FiberAndFiber/stm32f030f4p6_MAX7219_LED/software/Demo/User/inc/SOFT_SPI_DRIVER.h

#ifndef __SOFE_SPI_DRIVER_H
#define __SOFE_SPI_DRIVER_H

void SOFE_SPI_DRIVER_INIT(void);
void SOFE_SPI_DRIVER_START(void);
void SOFE_SPI_DRIVER_END(void);
void SOFE_SPI_DRIVER_SendByte(uint8_t ByteSend);

#endif
