FiberAndFiber/stm32f030f4p6_MAX7219_LED/software/Demo/Project/project.uvguix.V

<?xml version="1.0" encoding="UTF-8" standalone="no" ?>
<ProjectGui xmlns:xsi="http://www.w3.org/2001/XMLSchema-instance" xsi:noNamespaceSchemaLocation="project_guix.xsd">

  <SchemaVersion>-6.1</SchemaVersion>

  <Header>### uVision Project, (C) Keil Software</Header>

  <ViewPool/>

  <SECTreeCtrl>
    <View>
      <WinId>38003</WinId>
      <ViewName>Registers</ViewName>
      <TableColWidths>115 109</TableColWidths>
    </View>
    <View>
      <WinId>346</WinId>
      <ViewName>Code Coverage</ViewName>
      <TableColWidths>526 160</TableColWidths>
    </View>
    <View>
      <WinId>204</WinId>
      <ViewName>Performance Analyzer</ViewName>
      <TableColWidths>686</TableColWidths>
    </View>
  </SECTreeCtrl>

  <TreeListPane>
    <View>
      <WinId>1506</WinId>
      <ViewName>Symbols</ViewName>
      <UserString></UserString>
      <TableColWidths>47 47 47</TableColWidths>
    </View>
    <View>
      <WinId>1936</WinId>
      <ViewName>Watch 1</ViewName>
      <UserString></UserString>
      <TableColWidths>47 47 47</TableColWidths>
    </View>
    <View>
      <WinId>1937</WinId>
      <ViewName>Watch 2</ViewName>
      <UserString></UserString>
      <TableColWidths>47 47 47</TableColWidths>
    </View>
    <View>
      <WinId>1935</WinId>
      <ViewName>Call Stack + Locals</ViewName>
      <UserString></UserString>
      <TableColWidths>47 47 47</TableColWidths>
    </View>
    <View>
      <WinId>2506</WinId>
      <ViewName>Trace Data</ViewName>
      <UserString></UserString>
      <TableColWidths>75 135 130 95 70 230 200 150</TableColWidths>
    </View>
    <View>
      <WinId>466</WinId>
      <ViewName>Source Browser</ViewName>
      <UserString>300</UserString>
      <TableColWidths>0</TableColWidths>
    </View>
  </TreeListPane>

  <CompViewPool/>

  <WindowSettings>
    <LogicAnalizer>
      <ShowLACursor>1</ShowLACursor>
      <ShowSignalInfo>1</ShowSignalInfo>
      <ShowCycles>0</ShowCycles>
      <LeftSideBarSize>0</LeftSideBarSize>
      <TimeBaseIndex>-1</TimeBaseIndex>
    </LogicAnalizer>
  </WindowSettings>

  <WinLayoutEx>
    <sActiveDebugView></sActiveDebugView>
    <WindowPosition>
      <length>44</length>
      <flags>2</flags>
      <showCmd>3</showCmd>
      <MinPosition>
        <xPos>-1</xPos>
        <yPos>-1</yPos>
      </MinPosition>
      <MaxPosition>
        <xPos>-1</xPos>
        <yPos>-1</yPos>
      </MaxPosition>
      <NormalPosition>
        <Top>131</Top>
        <Left>182</Left>
        <Right>1279</Right>
        <Bottom>679</Bottom>
      </NormalPosition>
    </WindowPosition>
    <MDIClientArea>
      <RegID>0</RegID>
      <MDITabState>
        <Len>60</Len>
        <Data>010000000400000001000000010000000100000001000000000000000200000000000000010000000100000000000000280000002800000000000000</Data>
      </MDITabState>
    </MDIClientArea>
    <ViewEx>
      <ViewType>0</ViewType>
      <ViewName>Build</ViewName>
      <Window>
        <RegID>-1</RegID>
        <PaneID>-1</PaneID>
        <IsVisible>0</IsVisible>
        <IsFloating>0</IsFloating>
        <IsTabbed>0</IsTabbed>
        <IsActivated>0</IsActivated>
        <MRUWidth>32767</MRUWidth>
        <PinState>0</PinState>
        <RecentFrameAlignment>4096</RecentFrameAlignment>
        <RecentRowIndex>0</RecentRowIndex>
        <RectRecentDocked>
          <Len>16</Len>
          <Data>920000004F0000004603000084000000</Data>
        </RectRecentDocked>
        <RectRecentFloat>
          <Len>16</Len>
          <Data>9200000066000000460300009B000000</Data>
        </RectRecentFloat>
      </Window>
      <Window>
        <RegID>1005</RegID>
        <PaneID>1005</PaneID>
        <IsVisible>1</IsVisible>
        <IsFloating>0</IsFloating>
        <IsTabbed>0</IsTabbed>
        <IsActivated>0</IsActivated>
        <MRUWidth>32767</MRUWidth>
        <PinState>0</PinState>
        <RecentFrameAlignment>4096</RecentFrameAlignment>
        <RecentRowIndex>0</RecentRowIndex>
        <RectRecentDocked>
          <Len>16</Len>
          <Data>0300000066000000E7000000A5010000</Data>
        </RectRecentDocked>
        <RectRecentFloat>
          <Len>16</Len>
          <Data>7000000087000000FE000000F8000000</Data>
        </RectRecentFloat>
      </Window>
      <Window>
        <RegID>109</RegID>
        <PaneID>109</PaneID>
        <IsVisible>1</IsVisible>
        <IsFloating>0</IsFloating>
        <IsTabbed>0</IsTabbed>
        <IsActivated>0</IsActivated>
        <MRUWidth>32767</MRUWidth>
        <PinState>0</PinState>
        <RecentFrameAlignment>4096</RecentFrameAlignment>
        <RecentRowIndex>0</RecentRowIndex>
        <RectRecentDocked>
          <Len>16</Len>
          <Data>0300000066000000E7000000A5010000</Data>
        </RectRecentDocked>
        <RectRecentFloat>
          <Len>16</Len>
          <Data>700000008700000017010000AA010000</Data>
        </RectRecentFloat>
      </Window>
      <Window>
        <RegID>1465</RegID>
        <PaneID>1465</PaneID>
        <IsVisible>0</IsVisible>
        <IsFloating>0</IsFloating>
        <IsTabbed>0</IsTabbed>
        <IsActivated>0</IsActivated>
        <MRUWidth>32767</MRUWidth>
        <PinState>0</PinState>
        <RecentFrameAlignment>4096</RecentFrameAlignment>
        <RecentRowIndex>0</RecentRowIndex>
        <RectRecentDocked>
          <Len>16</Len>
          <Data>030000000B010000430300003F010000</Data>
        </RectRecentDocked>
        <RectRecentFloat>
          <Len>16</Len>
          <Data>700000008700000013020000CF000000</Data>
        </RectRecentFloat>
      </Window>
      <Window>
        <RegID>1466</RegID>
        <PaneID>1466</PaneID>
        <IsVisible>0</IsVisible>
        <IsFloating>0</IsFloating>
        <IsTabbed>0</IsTabbed>
        <IsActivated>0</IsActivated>
        <MRUWidth>32767</MRUWidth>
        <PinState>0</PinState>
        <RecentFrameAlignment>4096</RecentFrameAlignment>
        <RecentRowIndex>0</RecentRowIndex>
        <RectRecentDocked>
          <Len>16</Len>
          <Data>030000000B010000430300003F010000</Data>
        </RectRecentDocked>
        <RectRecentFloat>
          <Len>16</Len>
          <Data>700000008700000013020000CF000000</Data>
        </RectRecentFloat>
      </Window>
      <Window>
        <RegID>1467</RegID>
        <PaneID>1467</PaneID>
        <IsVisible>0</IsVisible>
        <IsFloating>0</IsFloating>
        <IsTabbed>0</IsTabbed>
        <IsActivated>0</IsActivated>
        <MRUWidth>32767</MRUWidth>
        <PinState>0</PinState>
        <RecentFrameAlignment>4096</RecentFrameAlignment>
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
        <RecentFrameAlignment>8192</RecentFrameAlignment>
        <RecentRowIndex>1</RecentRowIndex>
        <RectRecentDocked>
          <Len>16</Len>
          <Data>000000001C000000DA01000038000000</Data>
        </RectRecentDocked>
        <RectRecentFloat>
          <Len>16</Len>
          <Data>0A0000000A0000006E0000006E000000</Data>
        </RectRecentFloat>
      </Window>
      <Window>
        <RegID>59400</RegID>
        <PaneID>59400</PaneID>
        <IsVisible>0</IsVisible>
        <IsFloating>0</IsFloating>
        <IsTabbed>0</IsTabbed>
        <IsActivated>0</IsActivated>
        <MRUWidth>612</MRUWidth>
        <PinState>0</PinState>
        <RecentFrameAlignment>8192</RecentFrameAlignment>
        <RecentRowIndex>2</RecentRowIndex>
        <RectRecentDocked>
          <Len>16</Len>
          <Data>00000000380000006F02000054000000</Data>
        </RectRecentDocked>
        <RectRecentFloat>
          <Len>16</Len>
          <Data>0A0000000A0000006E0000006E000000</Data>
        </RectRecentFloat>
      </Window>
      <Window>
        <RegID>824</RegID>
        <PaneID>824</PaneID>
        <IsVisible>0</IsVisible>
        <IsFloating>0</IsFloating>
        <IsTabbed>0</IsTabbed>
        <IsActivated>0</IsActivated>
        <MRUWidth>32767</MRUWidth>
        <PinState>0</PinState>
        <RecentFrameAlignment>4096</RecentFrameAlignment>
        <RecentRowIndex>0</RecentRowIndex>
        <RectRecentDocked>
          <Len>16</Len>
          <Data>030000000B010000430300003F010000</Data>
        </RectRecentDocked>
        <RectRecentFloat>
          <Len>16</Len>
          <Data>7000000087000000FE000000F8000000</Data>
        </RectRecentFloat>
      </Window>
      <DockMan>
        <Len>3236</Len>
        <Data>000000000B000000000000000020000000000000FFFFFFFFFFFFFFFF92000000840000004603000088000000000000000100000004000000010000000000000000000000FFFFFFFF06000000CB00000057010000CC000000F08B00005A01000079070000FFFF02000B004354616262656450616E6500200000000000009200000066000000460300009B000000920000004F00000046030000840000000000000040280046060000000B446973617373656D626C7900000000CB00000001000000FFFFFFFFFFFFFFFF14506572666F726D616E636520416E616C797A6572000000005701000001000000FFFFFFFFFFFFFFFF14506572666F726D616E636520416E616C797A657200000000CC00000001000000FFFFFFFFFFFFFFFF0E4C6F67696320416E616C797A657200000000F08B000001000000FFFFFFFFFFFFFFFF0D436F646520436F766572616765000000005A01000001000000FFFFFFFFFFFFFFFF11496E737472756374696F6E205472616365000000007907000001000000FFFFFFFFFFFFFFFFFFFFFFFF000000000000000000000000000000000000000001000000FFFFFFFFCB00000001000000FFFFFFFFCB000000000000000040000000000000FFFFFFFFFFFFFFFFB40200004F000000B8020000F0000000000000000200000004000000010000000000000000000000FFFFFFFF2B000000E2050000CA0900002D8C00002E8C00002F8C0000308C0000318C0000328C0000338C0000348C0000358C0000368C0000378C0000388C0000398C00003A8C00003B8C00003C8C00003D8C00003E8C00003F8C0000408C0000418C000050C3000051C3000052C3000053C3000054C3000055C3000056C3000057C3000058C3000059C300005AC300005BC300005CC300005DC300005EC300005FC3000060C3000061C3000062C3000063C3000001800040000000000000B8020000660000004603000007010000B80200004F00000046030000F000000000000000404100462B0000000753796D626F6C73000000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
00000001000000FFFFFFFFFFFFFFFF0D46696E6420496E2046696C657300000000C700000001000000FFFFFFFFFFFFFFFF0A4572726F72204C69737400000000B401000001000000FFFFFFFFFFFFFFFF0E536F757263652042726F7773657200000000D201000001000000FFFFFFFFFFFFFFFF1346696E6420416C6C205265666572656E63657300000000CF01000001000000FFFFFFFFFFFFFFFF0742726F77736572000000007794000001000000FFFFFFFFFFFFFFFF00000000000000000000000000000000000000000000000001000000FFFFFFFFC500000001000000FFFFFFFFC5000000000000000000000000000000</Data>
      </DockMan>
      <ToolBar>
        <RegID>59392</RegID>
        <Name>File</Name>
        <Buttons>
          <Len>2049</Len>
          <Data>00200000010000002800FFFF01001100434D4643546F6F6C426172427574746F6E00E100000000000000000000000000000000000000000000000100000001000000018001E100000000000001000000000000000000000000000000000100000001000000018003E1000000000400020000000000000000000000000000000001000000010000000180CD7F0000000000000300000000000000000000000000000000010000000100000001800000000001000000FFFFFFFF000000000000000000000000000100000001000000018023E100000000040004000000000000000000000000000000000100000001000000018022E100000000040005000000000000000000000000000000000100000001000000018025E10000000004000600000000000000000000000000000000010000000100000001800000000001000000FFFFFFFF00000000000000000000000000010000000100000001802BE10000000004000700000000000000000000000000000000010000000100000001802CE10000000004000800000000000000000000000000000000010000000100000001800000000001000000FFFFFFFF00000000000000000000000000010000000100000001807A8A0000000004000900000000000000000000000000000000010000000100000001807B8A0000000004000A00000000000000000000000000000000010000000100000001800000000001000000FFFFFFFF0000000000000000000000000001000000010000000180D3B00000000004000B000000000000000000000000000000000100000001000000018015B10000000004000C0000000000000000000000000000000001000000010000000180F4B00000000004000D000000000000000000000000000000000100000001000000018036B10000000004000E00000000000000000000000000000000010000000100000001800000000001000000FFFFFFFF0000000000000000000000000001000000010000000180FF8800000000040046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
        </OrigResetItems>
      </ToolBar>
      <ControlBarsSummary>
        <Bars>0</Bars>
        <ScreenCX>1138</ScreenCX>
        <ScreenCY>640</ScreenCY>
      </ControlBarsSummary>
    </ViewEx>
  </WinLayoutEx>

</ProjectGui>
