FiberAndFiber/stm32f030f4p6_MAX7219_LED/software/Demo/User/inc/main.h

/**
  ******************************************************************************
  * @file    Project/STM32F0xx_StdPeriph_Templates/main.h 
  * @author  MCD Application Team
  * @version V1.6.0
  * @date    13-October-2021
  * @brief   Header for main.c module
  ******************************************************************************
  * @attention
  *
  * Copyright (c) 2014 STMicroelectronics.
  * All rights reserved.
  *
  * This software is licensed under terms that can be found in the LICENSE file
  * in the root directory of this software component.
  * If no LICENSE file comes with this software, it is provided AS-IS.
  *
  ******************************************************************************
  */
  
/* Define to prevent recursive inclusion -------------------------------------*/
#ifndef __MAIN_H
#define __MAIN_H

/* Includes ------------------------------------------------------------------*/
#include "stm32f0xx.h"

#ifdef USE_STM320518_EVAL
 #include "stm320518_eval.h"
 #include "stm320518_eval_lcd.h"
#endif /* USE_STM320518_EVAL */

#ifdef USE_STM32072B_EVAL
 #include "stm32072b_eval.h"
 #include "stm32072b_eval_lcd.h"
#endif /* USE_STM32072B_EVAL */

/* Exported types ------------------------------------------------------------*/
/* Exported constants --------------------------------------------------------*/
/* Exported macro ------------------------------------------------------------*/
/* Exported functions ------------------------------------------------------- */

#endif /* __MAIN_H */
