FiberAndFiber/stm32f030f4p6_MAX7219_LED/software/Demo/User/inc/MPU6050.h

#ifndef __MPU6050_H
#define __MPU6050_H

void MPU6050_WriteReg(uint8_t RegAddress , uint8_t Data);
uint8_t MPU6050_ReadReg(uint8_t RegAddress);
void MPU6050_Init(void);
void MPU6050_GetData(int16_t *AccX,int16_t *AccY,int16_t *AccZ,
    int16_t *GccX,int16_t *GccY,int16_t *GccZ);

#endif
