FiberAndFiber/stm32f030f4p6_MAX7219_LED/software/Demo/User/inc/UART.h

#ifndef __UART_H
#define __UART_H

void Serial_Init();
void Serial_SendByte(uint8_t Byte);
void Serial_SendArray(uint8_t *Array,uint16_t Length);
void Serial_SendString(char *String);
void Serial_SendNumber(uint32_t Number,uint8_t Length);

uint8_t Serial_GetRxFlag(void);
uint8_t Serial_GetRxData(void);

#endif
